uino95/EDRO/main/player.cpp

#include "player.h"

Player::Player() {}

void Player::setup(int TX, int RX)
{

    SoftwareSerial mySoftwareSerial(TX, RX); // TX verde, RX giallo
    mySoftwareSerial.begin(9600);

    Serial.println();
    Serial.println(F("DFRobot DFPlayer Mini Demo"));
    Serial.println(F("Initializing DFPlayer ... (May take 3~5 seconds)"));

    if (!myDFPlayer.begin(mySoftwareSerial))    //Use softwareSerial to communicate with mp3.
    {
        Serial.println(F("Unable to begin:"));
        Serial.println(F("1.Please recheck the connection!"));
        Serial.println(F("2.Please insert the SD card!"));
        while(true);
    }
    Serial.println(F("DFPlayer Mini online."));
}

void Player::play(int song)
{
    Serial.println("I'm playing the song");
    myDFPlayer.play(song);
}

void Player::setVolume(int volume)
{
    myDFPlayer.volume(volume);
}

void Player::stop()
{
    myDFPlayer.stop();
}

void Player::printDetail(uint8_t type, int value)
{
    switch (type)
    {
    case TimeOut:
        Serial.println(F("Time Out!"));
        break;
    case WrongStack:
        Serial.println(F("Stack Wrong!"));
        break;
    case DFPlayerCardInserted:
        Serial.println(F("Card Inserted!"));
        break;
    case DFPlayerCardRemoved:
        Serial.println(F("Card Removed!"));
        break;
    case DFPlayerCardOnline:
        Serial.println(F("Card Online!"));
        break;
    case DFPlayerPlayFinished:
        Serial.print(F("Number:"));
        Serial.print(value);
        Serial.println(F(" Play Finished!"));
        break;
    case DFPlayerError:
        Serial.print(F("DFPlayerError:"));
        switch (value)
        {
        case Busy:
            Serial.println(F("Card not found"));
            break;
        case Sleeping:
            Serial.println(F("Sleeping"));
            break;
        case SerialWrongStack:
            Serial.println(F("Get Wrong Stack"));
            break;
        case CheckSumNotMatch:
            Serial.println(F("Check Sum Not Match"));
            break;
        case FileIndexOut:
            Serial.println(F("File Index Out of Bound"));
            break;
        case FileMismatch:
            Serial.println(F("Cannot Find File"));
            break;
        case Advertise:
            Serial.println(F("In Advertise"));
            break;
        default:
            break;
        }
        break;
    default:
        break;
    }
}
